Sharif-University-ESRLab/project-97106165-97106121/Code/ReadMe

This folder should contain the source code of your project.
