Sharif-University-ESRLab/project-97106165-97106121/Miscellaneous/max-range-fixed-5.JPG

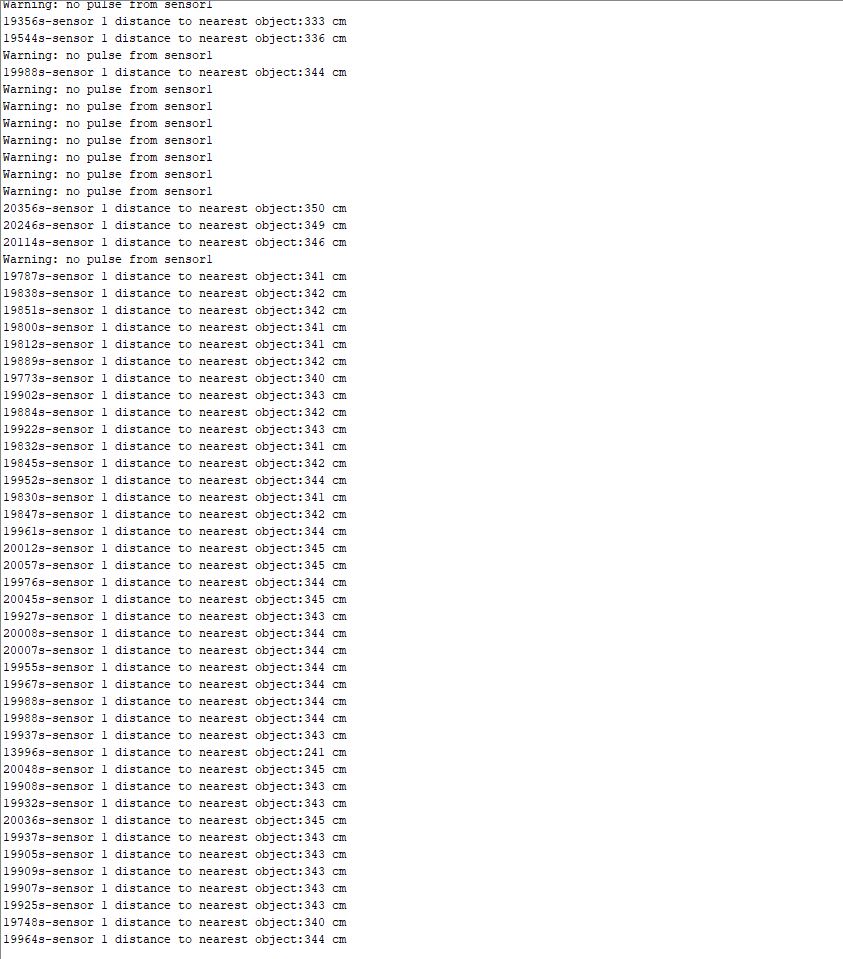
Miscellaneous/max-range-fixed-5.JPG
