Sharif-University-ESRLab/project-97106165-97106121/Miscellaneous/sensor+fixed-vltage.JPG

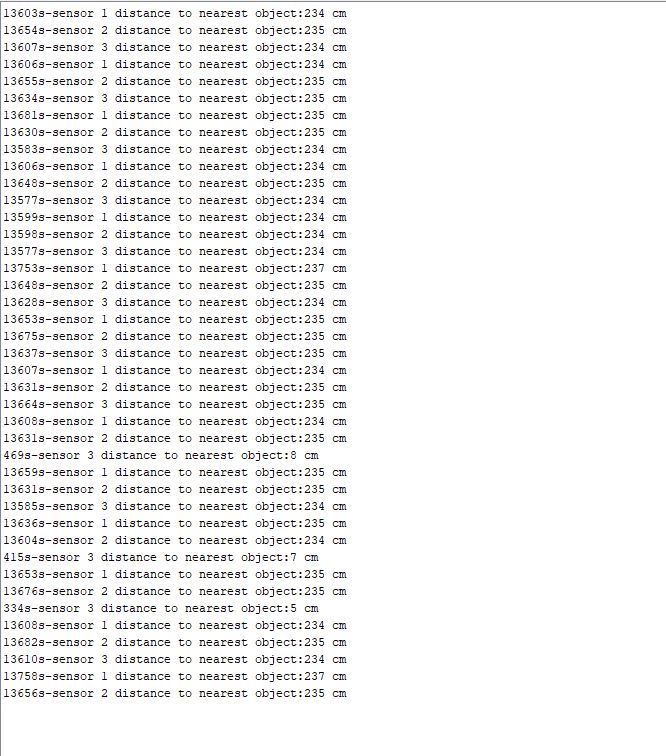
Miscellaneous/sensor+fixed-vltage.JPG
