Sharif-University-ESRLab/project-97106165-97106121/Miscellaneous/sensor+HC05+cmommom-vltage.JPG

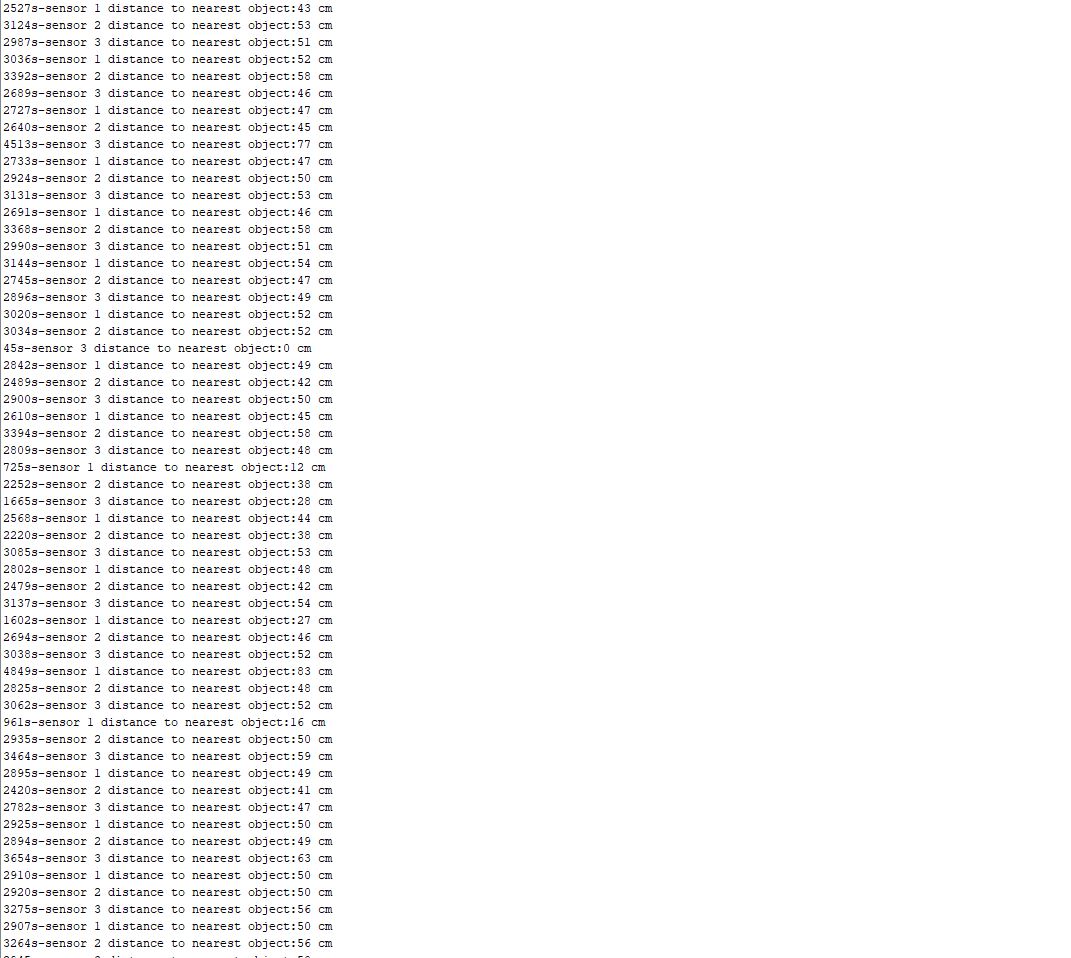
Miscellaneous/sensor+HC05+cmommom-vltage.JPG
