Sharif-University-ESRLab/project-97106165-97106121/Code/Rasberry pi3/test_rfcomm_sever.py

# should run in raspberry pi

import bluetooth


def main():
    server_sock=bluetooth.BluetoothSocket( bluetooth.RFCOMM )
    port = 1
    server_sock.bind(("",port))
    server_sock.listen(1)
    client_sock,address = server_sock.accept()
    print("Accepted connection from ",address)
    data = client_sock.recv(1024)
    print(f"received [{data}]")
    client_sock.close()
    server_sock.close()


if __name__ == "__main__":
    main()
