Sharif-University-ESRLab/project-97106165-97106121/(commit log)

2022-08-09 distance measurement with ultrasonic SRF05
    calibration is not accurate.
2022-08-10 codes for 4 sensors
    need testing and connecting via bluetooth
2022-08-21 Add bluetooth code for arduino to connect to mobile
2022-08-22 code for srf05 sensors. Bluetooth is not added.
2022-08-22 fix bug for sensor2
    [sensores_without_bluetooth_.ino, test.ino]
2022-08-22 add warning logic and bluetooth to arduino code
2022-08-23 Connect android to arduino and get sensors data
2022-08-23 change sleep duration t0 200ms and rewrite code with 3 sensor and add function for distance measurment
2022-09-03 raspberry pi datasheet
2022-09-03 arduino datasheet
